bry4b/suite61/suite61pcb/joycon_joystick_board.jpg

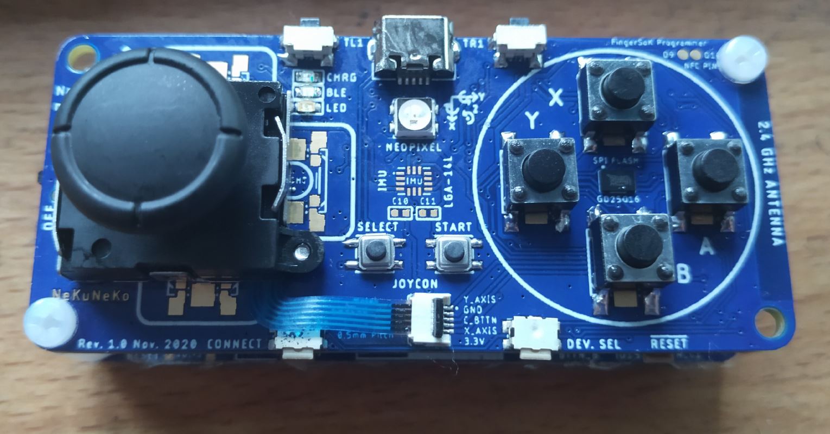
suite61pcb/joycon_joystick_board.jpg
