bry4b/suite61/README.md

# suite61
 split ergo with numrow, arrows, and a stick
