bry4b/suite61/suite61pcb/joystick_schematic.png

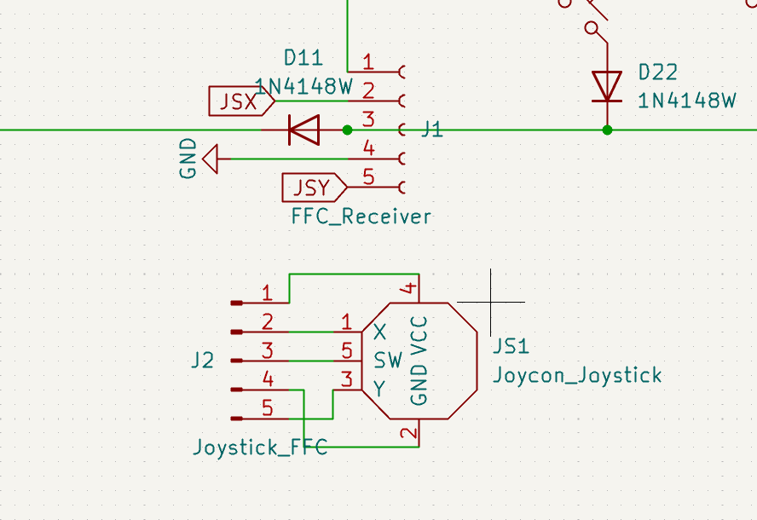
suite61pcb/joystick_schematic.png
