bry4b/suite61/suite61_bom.xlsx

part name | part number | qty. | price / lot | total price | lot size | required | notes | purchased? | link
PCB
nice!nano |  | 2 | $25.00 | $50.00 | 1 | 2 | nrf52840
kailh hotswap sockets |  | 1 | $12.50 | $12.50 | 100 | 61 | hotswap sockets | y | https://www.aliexpress.com/item/2251832764937566.html
nintendo joycon joystick replacement |  | 1 | $4.99 | $4.99 | 2 | 2 | joystick | y | https://www.aliexpress.com/item/3256802772475303.html
ffc connector |  | 1 | $0.74 | $0.74 | 10 | 2 | .5mm trace, 5 pin | y | https://www.aliexpress.com/item/2251832700238041.html
slide switch spdt | msk12c01 | 1 | $0.62 | $0.62 | 10 | 2 | 2mm height | y | https://www.aliexpress.com/item/3256803121871877.html
pin header |  | 1 | $0.73 | $0.73 | 10 | 1 | 1x40 male, 2.54mm | y | https://www.aliexpress.com/item/2255800671070360.html
pin socket bc im stupid |  | 1 | $2.29 | $2.29 | 10 | 1 | need 2x12, 1x3 female per n!n; 2.54mmx3mm | y | https://www.aliexpress.us/item/2251832706072027.html?pdp_ext_f=%7B"sku_id"%3A"12000028007443295"%7D&pdp_npi=3%40dis%21USD%212.29%212.29%21%21%21%21%21%40211bf3f816773167375513634d0761%2112000028007443295%21sea%21US%212398827239&curPageLogUid=fjkYiyRKcfNy
reset button | CKN11328-ND | 0 | $0.26 | $0.00 |  | 2 | any generic tactile button, short to gnd | own | https://www.digikey.com/short/8z4j0w37
lipo battery |  |  |  | $0.00 |  | 2
jst connector for battery |  | 2 | $0.57 | $1.14 | 1 | 2 | need to find matching connector for battery side request sample from JST ez pz |  | https://www.digikey.com/short/zwnv0df0
rgb led | sk6812 | 1 | $7.26 | $7.26 | 50 | 12 | leds yay | y | https://www.aliexpress.com/item/3256805007401420.html
 |  |  |  | $0.00
 |  |  |  | $0.00
 |  |  |  | $0.00
 |  |  |  | $0.00
 |  |  |  | $0.00
 |  |  |  | $0.00
 |  |  |  | $0.00
 |  |  |  | $0.00
 |  |  |  | $0.00
 |  |  |  | $0.00
 |  |  |  | $0.00
