bry4b/suite61/suite61pcb/suite61pcb.kicad_pcb

## KiCad design suite61pcb/suite61pcb.kicad_pcb (2023-05-19)

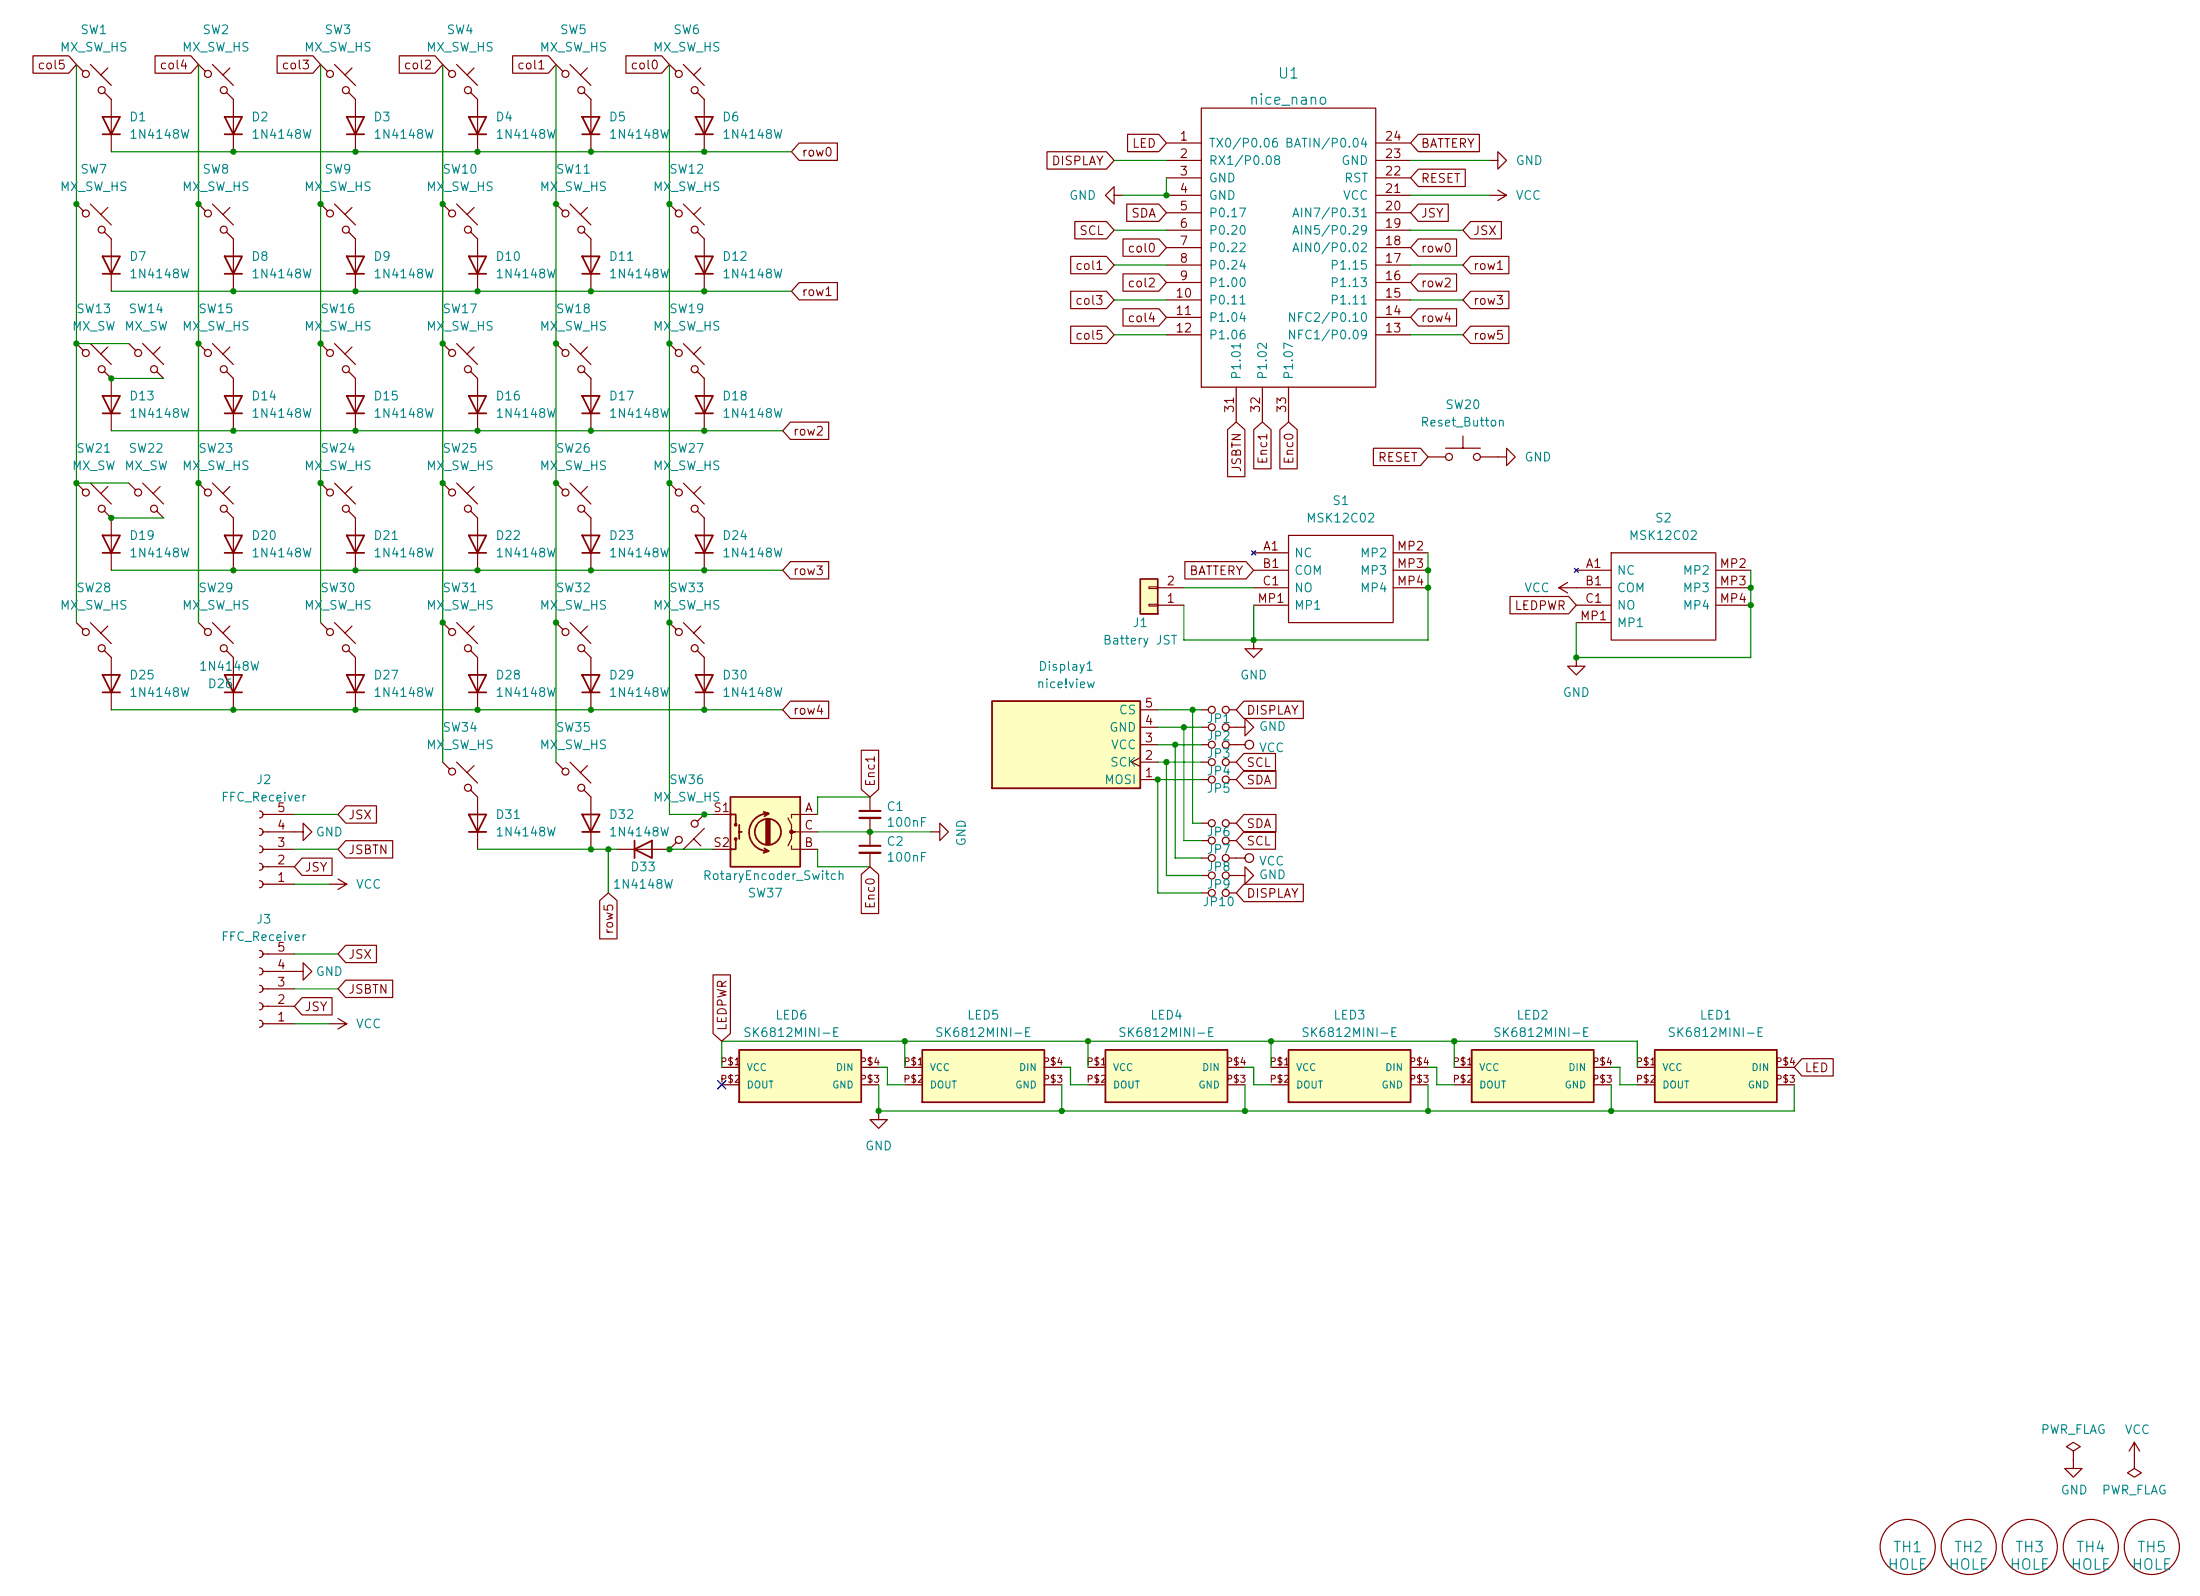
[picture p3: schematic suite61pcb.kicad_sch]

Parts:
C1, C2: 100nF; C_0805_2012Metric
D1, D2, D3, D4, D5, D6, D7, D8, D9, D10, D11, D12, D13, D14, D15, D16, D17, D18, D19, D20, D21, D22, D23, D24, D25, D26, D27, D28, D29, D30, D31, D32, D33: 1N4148W; D_SOD-123
Display1: nice!view; nice_view
J1: Battery JST; JST_SH_SM02B-SRSS-TB_1x02-1MP_P1.00mm_Horizontal
J2, J3: FFC_Receiver; 5034800500
JP1, JP2, JP3, JP4, JP5, JP6, JP7, JP8, JP9, JP10: Jumper_NO_Small; jumper
LED1, LED2, LED3, LED4, LED5, LED6: SK6812MINI-E; LED_6028R
S1, S2: MSK12C02; Manufacturer_Part_Number MSK12C02
SW1, SW2, SW3, SW4, SW5, SW6, SW8, SW9, SW10, SW11, SW12, SW15, SW16, SW17, SW18, SW19, SW23, SW24, SW25, SW26, SW27, SW29, SW30, SW31, SW32, SW33, SW34, SW36: MX_SW_HS; CherryMX_Hotswap
SW7, SW28, SW35: MX_SW_HS; CherryMX_Hotswap_1.5
SW13: MX_SW; SW_MX_HS_1.75u
SW14, SW21: MX_SW; STAB_MX_P__HS_2.25u
SW20: Reset_Button; SW_Push_1P1T_NO_CK_KMR2
SW22: MX_SW; CherryMX_Hotswap
SW37: RotaryEncoder_Switch; RotaryEncoder_EC11
TH1, TH2, TH3, TH4, TH5: HOLE; MountingHole_3.7mm
U1: nice_nano

Connections:
BATTERY: S1.B1 (COM), U1.24 (BATIN/P0.04)
DISPLAY: JP1.2, JP10.2, U1.2 (RX1/P0.08)
Enc0: C2.2, SW37.B, U1.33 (P1.07)
Enc1: C1.1, SW37.A, U1.32 (P1.02)
GND: C1.2, C2.1, J1.1, J2.4, J3.4, JP2.2, JP9.2, LED1.P$3 (GND), LED2.P$3 (GND), LED3.P$3 (GND), LED4.P$3 (GND), LED5.P$3 (GND), LED6.P$3 (GND), S1.MP1, S1.MP2, S1.MP3, S1.MP4, S2.MP1, S2.MP2, S2.MP3, S2.MP4, SW20.2, SW37.C, U1.3 (GND), U1.4 (GND), U1.23 (GND)
JSBTN: J2.3, J3.3, U1.31 (P1.01)
JSX: J2.5, J3.5, U1.19 (AIN5/P0.29)
JSY: J2.2, J3.2, U1.20 (AIN7/P0.31)
LED: LED1.P$4 (DIN), U1.1 (TX0/P0.06)
LEDPWR: LED1.P$1 (VCC), LED2.P$1 (VCC), LED3.P$1 (VCC), LED4.P$1 (VCC), LED5.P$1 (VCC), LED6.P$1 (VCC), S2.C1 (NO)
unnamed: D1.2 (A), SW1.2
unnamed: D2.2 (A), SW2.2
unnamed: D3.2 (A), SW3.2
unnamed: D4.2 (A), SW4.2
unnamed: D5.2 (A), SW5.2
unnamed: D6.2 (A), SW6.2
unnamed: D7.2 (A), SW7.2
unnamed: D8.2 (A), SW8.2
unnamed: D9.2 (A), SW9.2
unnamed: D10.2 (A), SW10.2
unnamed: D11.2 (A), SW11.2
unnamed: D12.2 (A), SW12.2
unnamed: D13.2 (A), SW13.2, SW14.2
unnamed: D14.2 (A), SW15.2
unnamed: D15.2 (A), SW16.2
unnamed: D16.2 (A), SW17.2
unnamed: D17.2 (A), SW18.2
unnamed: D18.2 (A), SW19.2
unnamed: D19.2 (A), SW21.2, SW22.2
unnamed: D20.2 (A), SW23.2
unnamed: D21.2 (A), SW24.2
unnamed: D22.2 (A), SW25.2
unnamed: D23.2 (A), SW26.2
unnamed: D24.2 (A), SW27.2
unnamed: D25.2 (A), SW28.2
unnamed: D26.2 (A), SW29.2
unnamed: D27.2 (A), SW30.2
unnamed: D28.2 (A), SW31.2
unnamed: D29.2 (A), SW32.2
unnamed: D30.2 (A), SW33.2
unnamed: D31.2 (A), SW34.2
unnamed: D32.2 (A), SW35.2
unnamed: D33.2 (A), SW36.1, SW37.S2
unnamed: Display1.1 (MOSI), JP5.1, JP10.1
unnamed: Display1.2 (SCK), JP4.1, JP9.1
unnamed: Display1.3 (VCC), JP3.1, JP8.1
unnamed: Display1.4 (GND), JP2.1, JP7.1
unnamed: Display1.5 (CS), JP1.1, JP6.1
unnamed: J1.2, S1.C1 (NO)
unnamed: LED1.P$2 (DOUT), LED2.P$4 (DIN)
unnamed: LED2.P$2 (DOUT), LED3.P$4 (DIN)
unnamed: LED3.P$2 (DOUT), LED4.P$4 (DIN)
unnamed: LED4.P$2 (DOUT), LED5.P$4 (DIN)
unnamed: LED5.P$2 (DOUT), LED6.P$4 (DIN)
RESET: SW20.1, U1.22 (RST)
SCL: JP4.2, JP7.2, U1.6 (P0.20)
SDA: JP5.2, JP6.2, U1.5 (P0.17)
VCC: J2.1, J3.1, JP3.2, JP8.2, S2.B1 (COM), U1.21 (VCC)
col0: SW6.1, SW12.1, SW19.1, SW27.1, SW33.1, SW36.2, SW37.S1, U1.7 (P0.22)
col1: SW5.1, SW11.1, SW18.1, SW26.1, SW32.1, SW35.1, U1.8 (P0.24)
col2: SW4.1, SW10.1, SW17.1, SW25.1, SW31.1, SW34.1, U1.9 (P1.00)
col3: SW3.1, SW9.1, SW16.1, SW24.1, SW30.1, U1.10 (P0.11)
col4: SW2.1, SW8.1, SW15.1, SW23.1, SW29.1, U1.11 (P1.04)
col5: SW1.1, SW7.1, SW13.1, SW14.1, SW21.1, SW22.1, SW28.1, U1.12 (P1.06)
row0: D1.1 (K), D2.1 (K), D3.1 (K), D4.1 (K), D5.1 (K), D6.1 (K), U1.18 (AIN0/P0.02)
row1: D7.1 (K), D8.1 (K), D9.1 (K), D10.1 (K), D11.1 (K), D12.1 (K), U1.17 (P1.15)
row2: D13.1 (K), D14.1 (K), D15.1 (K), D16.1 (K), D17.1 (K), D18.1 (K), U1.16 (P1.13)
row3: D19.1 (K), D20.1 (K), D21.1 (K), D22.1 (K), D23.1 (K), D24.1 (K), U1.15 (P1.11)
row4: D25.1 (K), D26.1 (K), D27.1 (K), D28.1 (K), D29.1 (K), D30.1 (K), U1.14 (NFC2/P0.10)
row5: D31.1 (K), D32.1 (K), D33.1 (K), U1.13 (NFC1/P0.09)

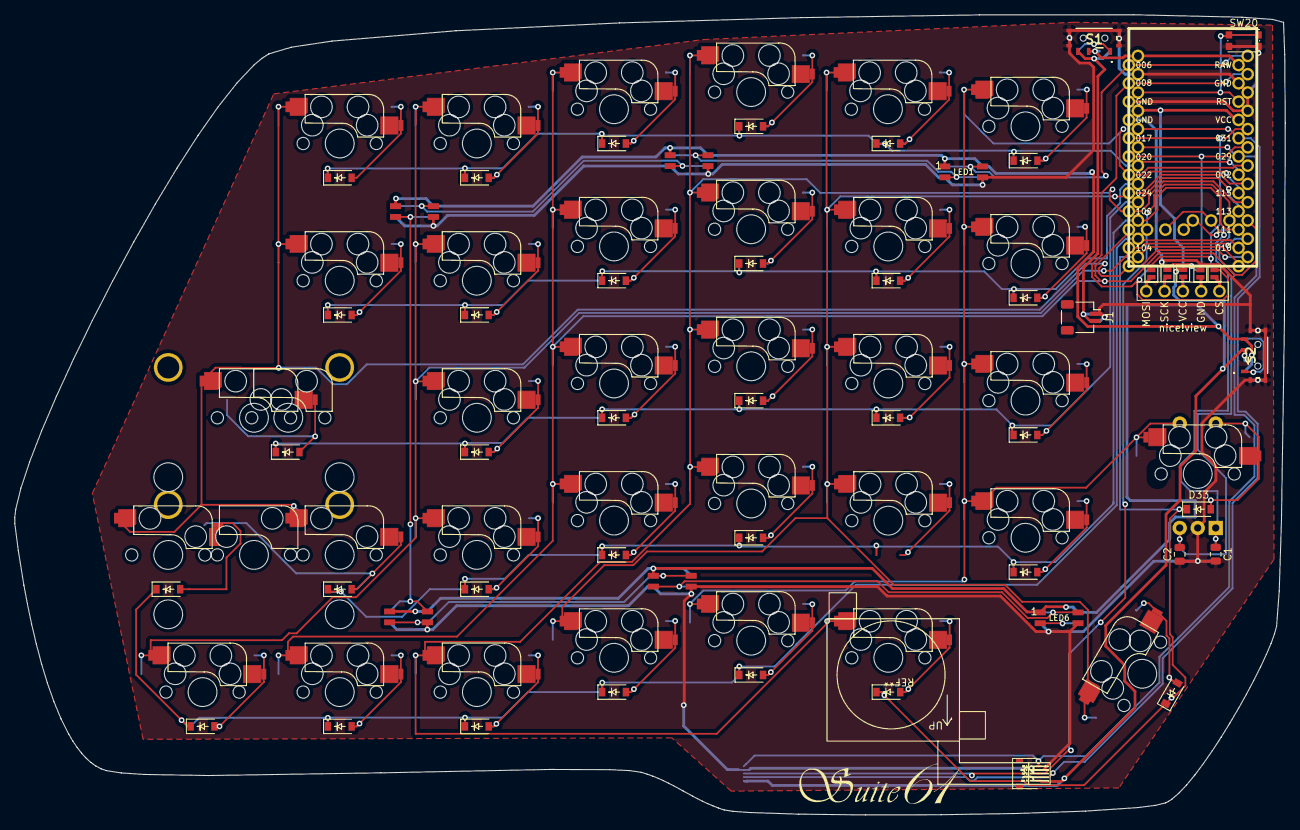
[picture p4: board suite61pcb.kicad_pcb from above]

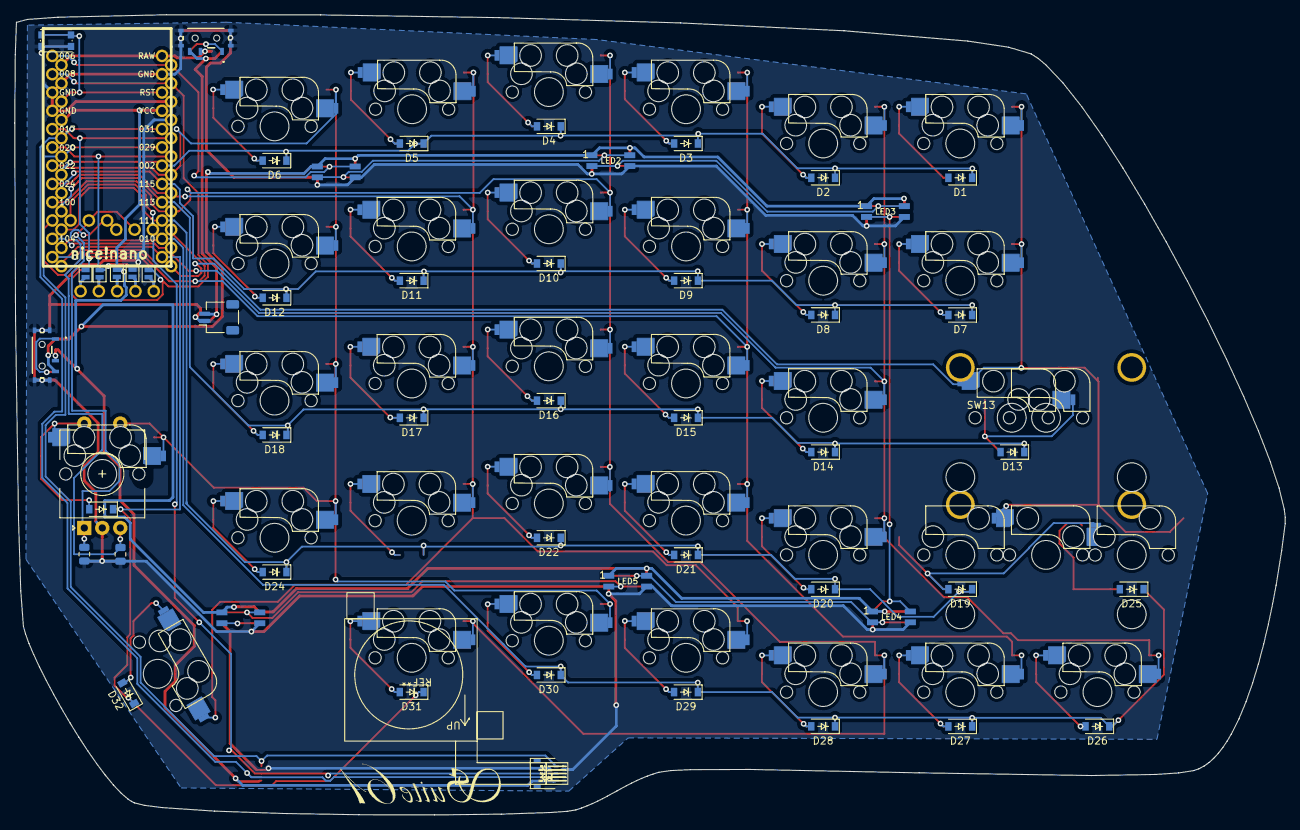
[picture p5: board suite61pcb.kicad_pcb from below]

Board: 2 copper layers, 176.5 x 111.1 mm, 99 parts (46 on the bottom side), 69 nets.
