bry4b/suite61/(commit log)

2023-02-20 create project
    [suite61pcb.kicad_pcb, suite61pcb.kicad_sch]
2023-02-20 add footprint libraries
    [suite61pcb.kicad_sch]
2023-02-20 update schematic
    [suite61pcb.kicad_pcb, suite61pcb.kicad_sch]
2023-02-20 create left pcb schematic
    [suite61pcb.kicad_pcb, suite61pcbleft.kicad_sch]
2023-02-20 Update matrix to 6x6
    [suite61pcb.kicad_sch]
2023-02-20 create led underglow schematic, upload shield matrix KLE json
    [suite61pcb.kicad_sch]
2023-02-21 update pcb
    [suite61pcb.kicad_pcb, suite61pcb.kicad_sch]
2023-02-22 update pcb and add keebio submod
    [suite61pcb.kicad_pcb, suite61pcb.kicad_sch]
2023-02-22 update pcb and schematic
    [suite61pcb.kicad_pcb, suite61pcb.kicad_sch]
2023-02-23 create edge outline
    [suite61pcb.kicad_pcb]
2023-02-25 update pcb
    check if oled header is right
    [suite61_bom.xlsx, suite61pcb.kicad_pcb]
2023-02-26 update pcb
    finished routing switch matrix, only need to do joystick & LEDs
    figure out how battery is gonna fit to keep underglow unobstructed
    decide on magnetic connector
    [suite61pcb.kicad_pcb, suite61pcb.kicad_sch]
2023-02-27 finished routing pcb, look into possible trrs + magnetic connection between halves
    [suite61_bom.xlsx, suite61pcb.kicad_pcb, suite61pcb.kicad_sch]
2023-02-28 routing & edge design
    finished routing pcb, added LED off switch
    drew edge design in illustrator subject to change
    [suite61pcb.kicad_pcb, suite61pcb.kicad_sch]
2023-03-08 create pcb edge cut
    [suite61pcb.kicad_pcb]
2023-03-22 update pcb w logo
    [suite61pcb.kicad_pcb]
2023-05-19 create gerbers
    pcb in production from jlcpcb!!!
    [suite61pcb-B_Cu.gbr, suite61pcb-B_Mask.gbr, suite61pcb-B_Silkscreen.gbr, suite61pcb-Edge_Cuts.gbr, suite61pcb-F_Cu.gbr, suite61pcb-F_Mask.gbr, suite61pcb-F_Silkscreen.gbr, suite61pcb-NPTH.drl]
